Thomasjp38/Kombucha/notebooks/john/temperature.png

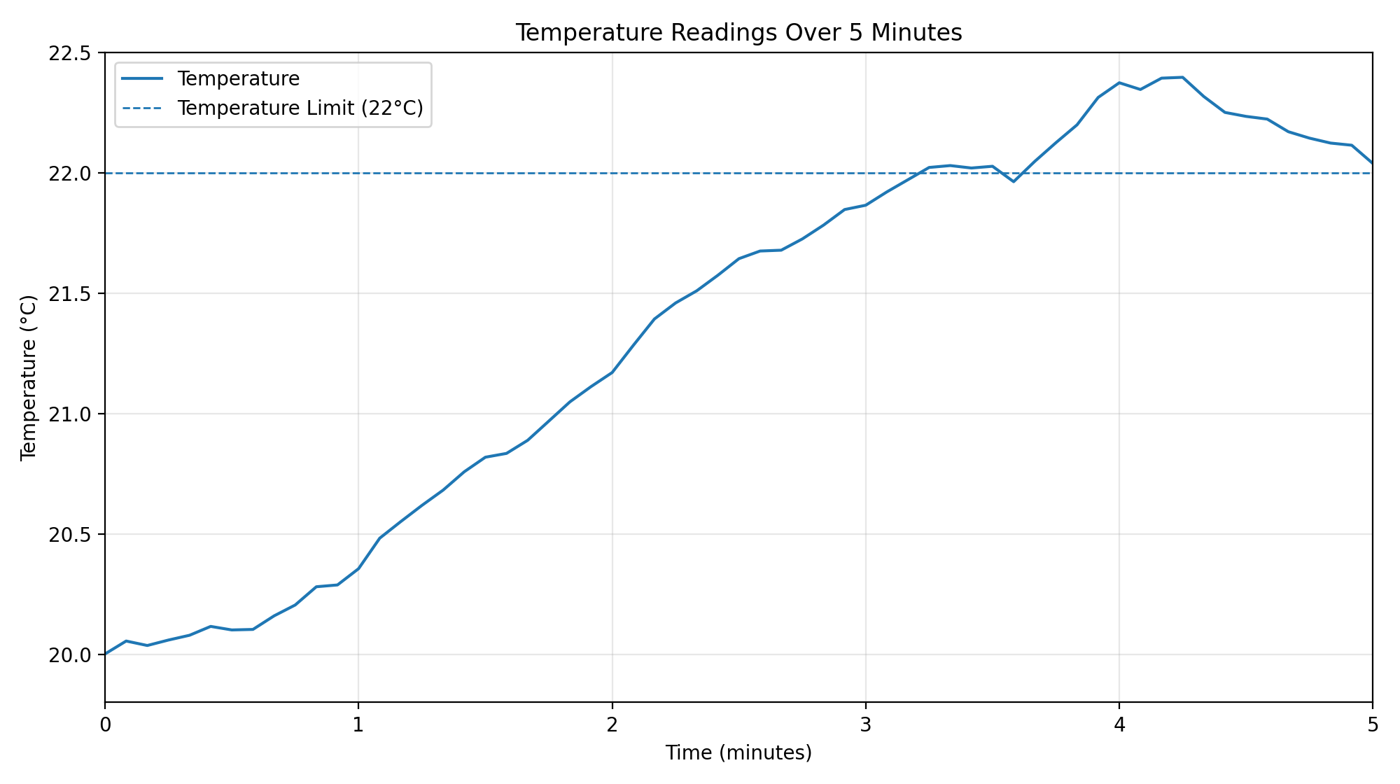
notebooks/john/temperature.png
