Thomasjp38/Kombucha/notebooks/rudy/IMG_6581.jpeg

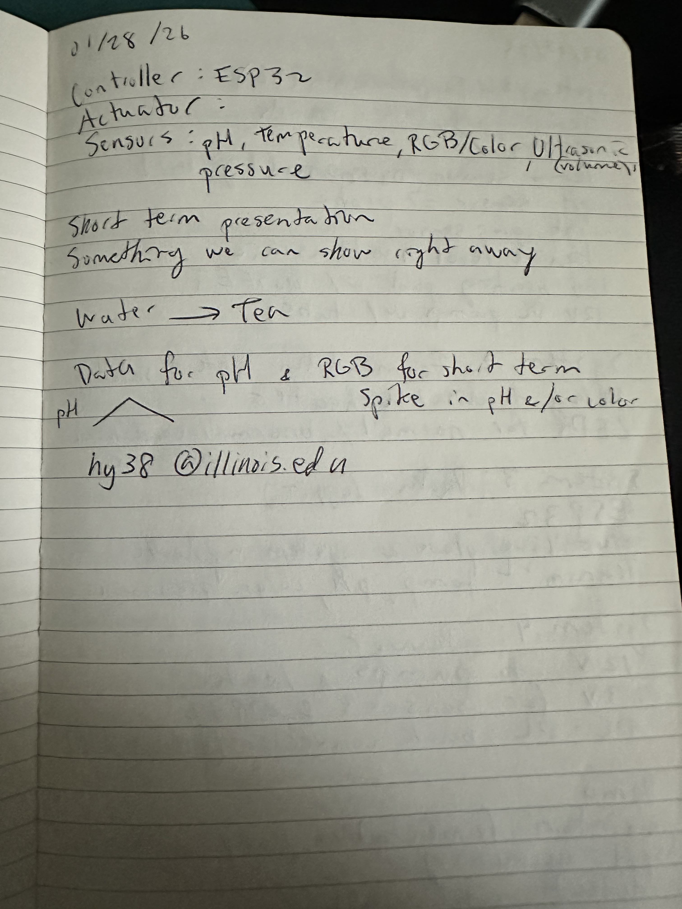
notebooks/rudy/IMG_6581.jpeg
