Thomasjp38/Kombucha/notebooks/rudy/IMG_6582.jpeg

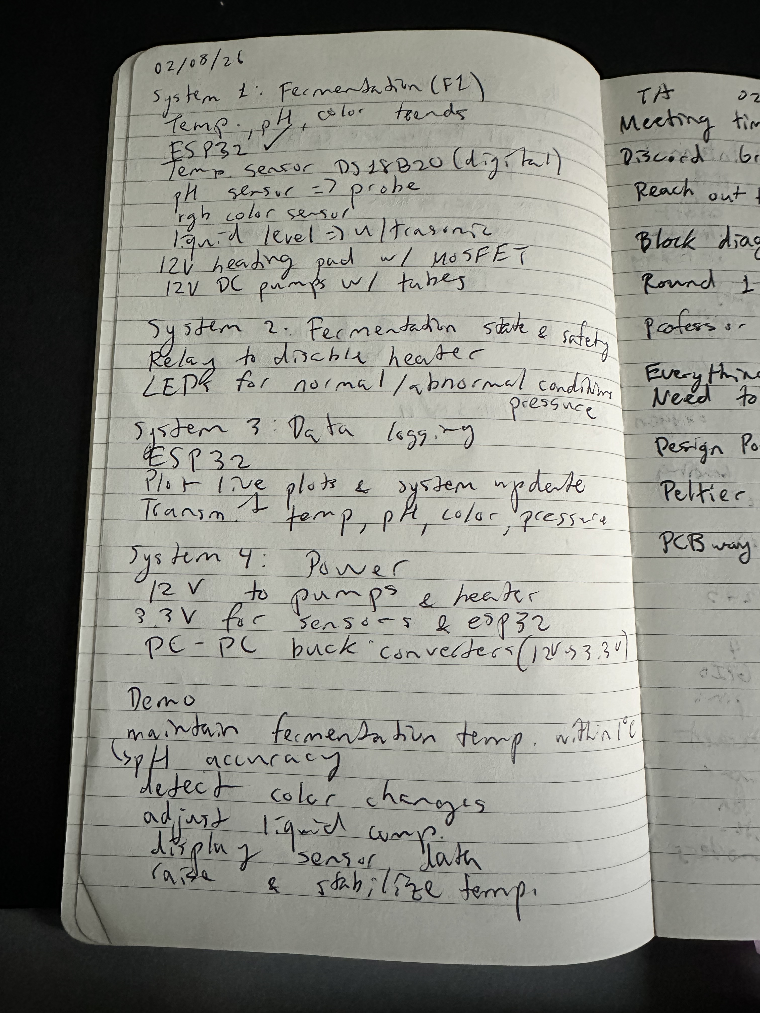
notebooks/rudy/IMG_6582.jpeg
