Thomasjp38/Kombucha/notebooks/rudy/IMG_6584.jpeg

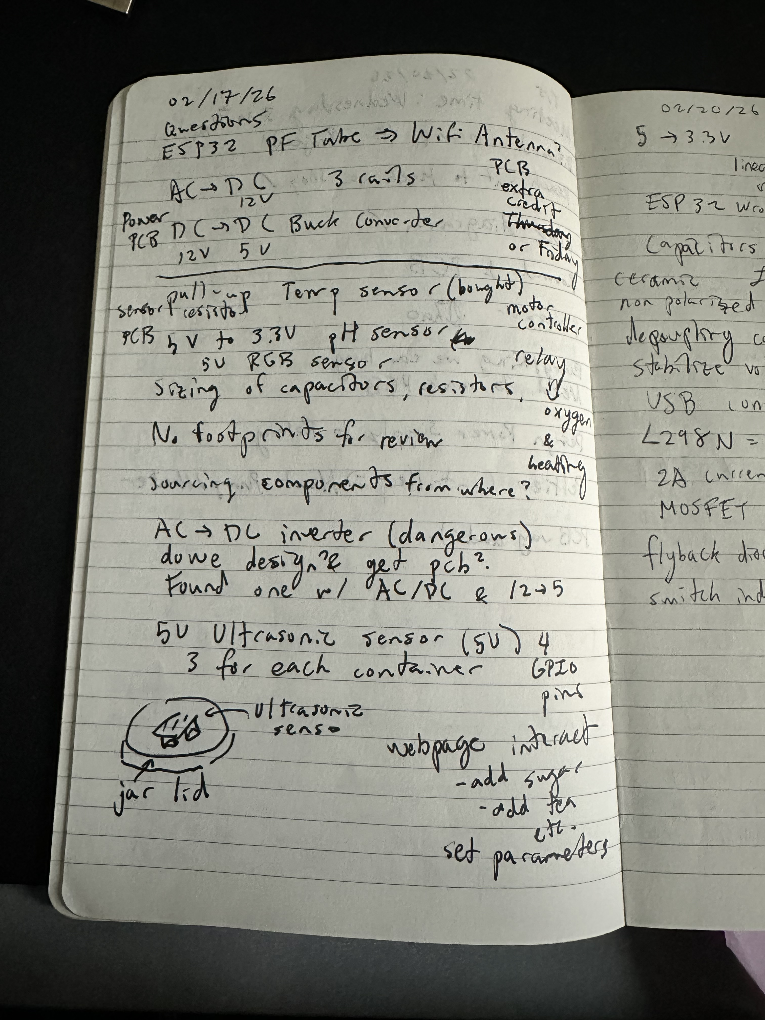
notebooks/rudy/IMG_6584.jpeg
