Thomasjp38/Kombucha/notebooks/rudy/IMG_6585.jpeg

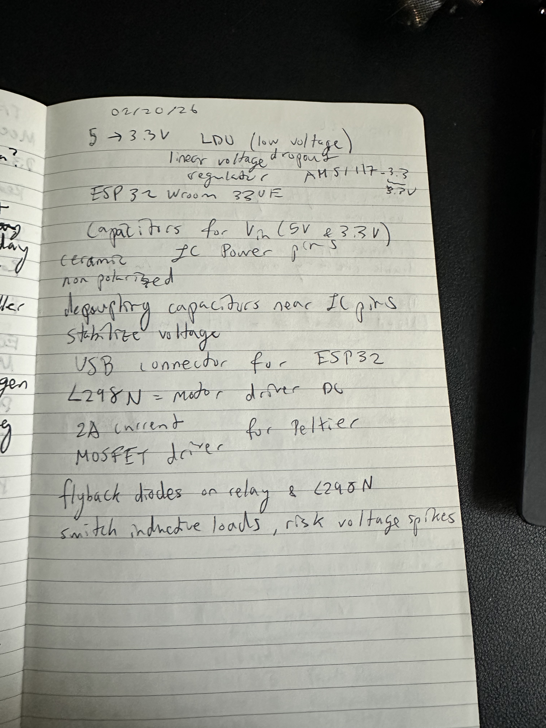
notebooks/rudy/IMG_6585.jpeg
