Thomasjp38/Kombucha/notebooks/rudy/IMG_6586.jpeg

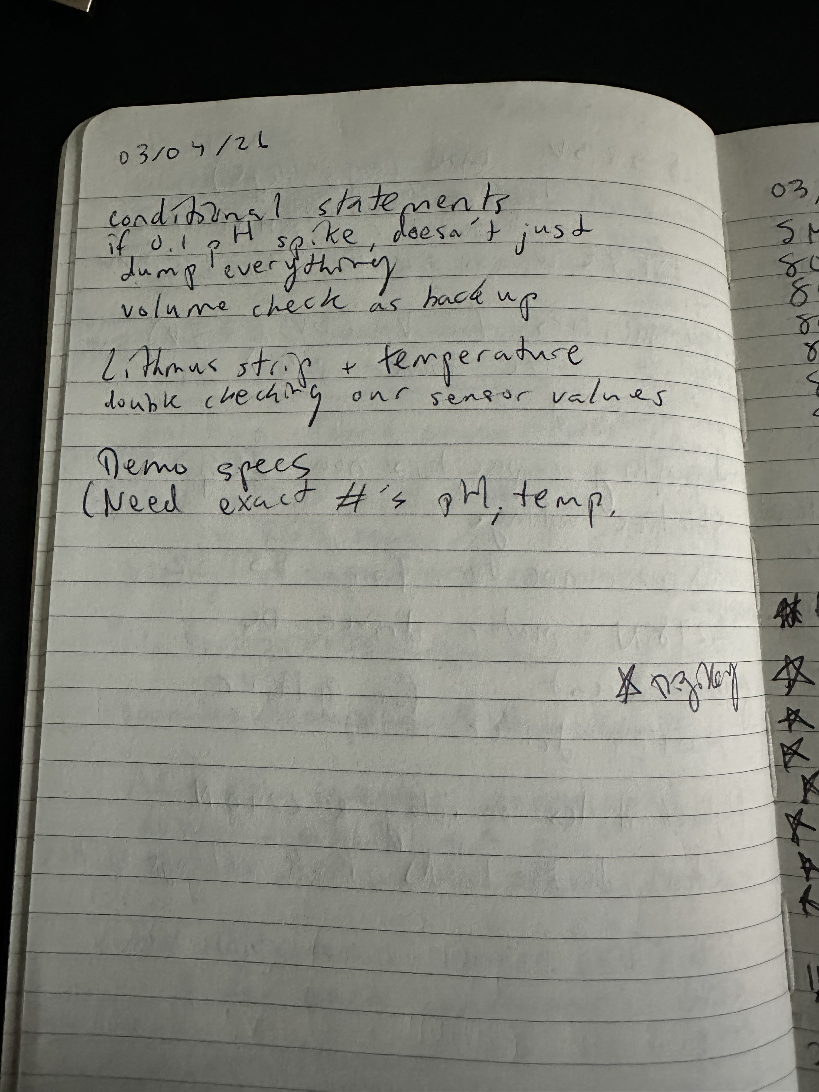
notebooks/rudy/IMG_6586.jpeg
