Thomasjp38/Kombucha/notebooks/rudy/IMG_6587.jpeg

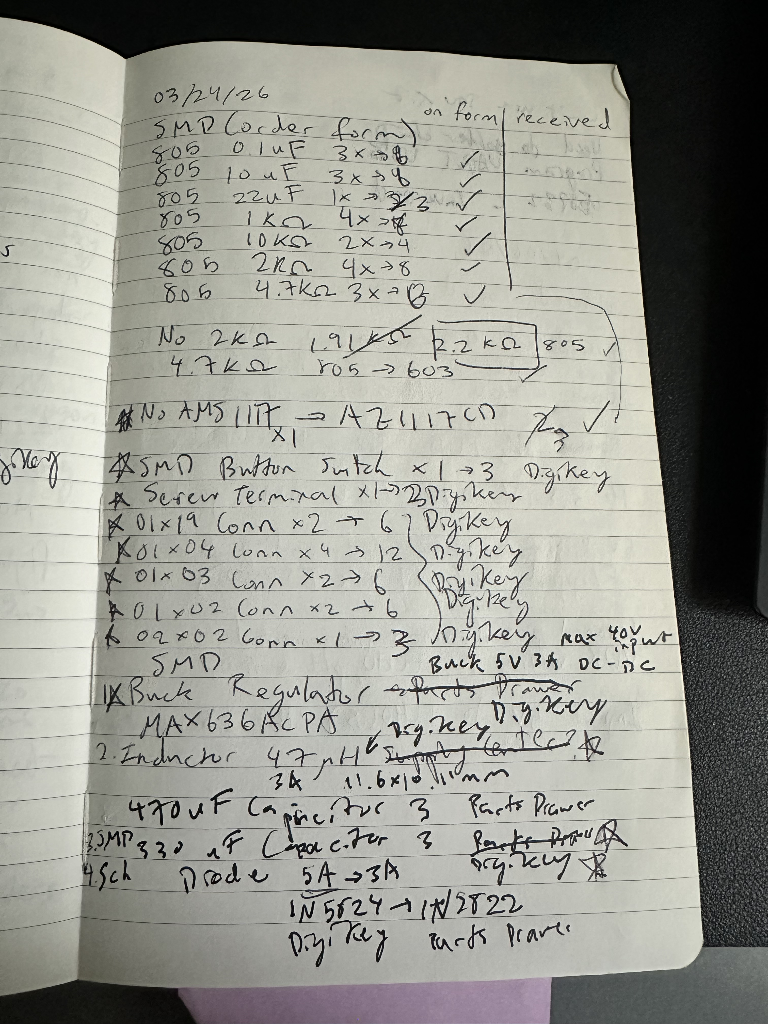
notebooks/rudy/IMG_6587.jpeg
