Thomasjp38/Kombucha/notebooks/rudy/IMG_6588.jpeg

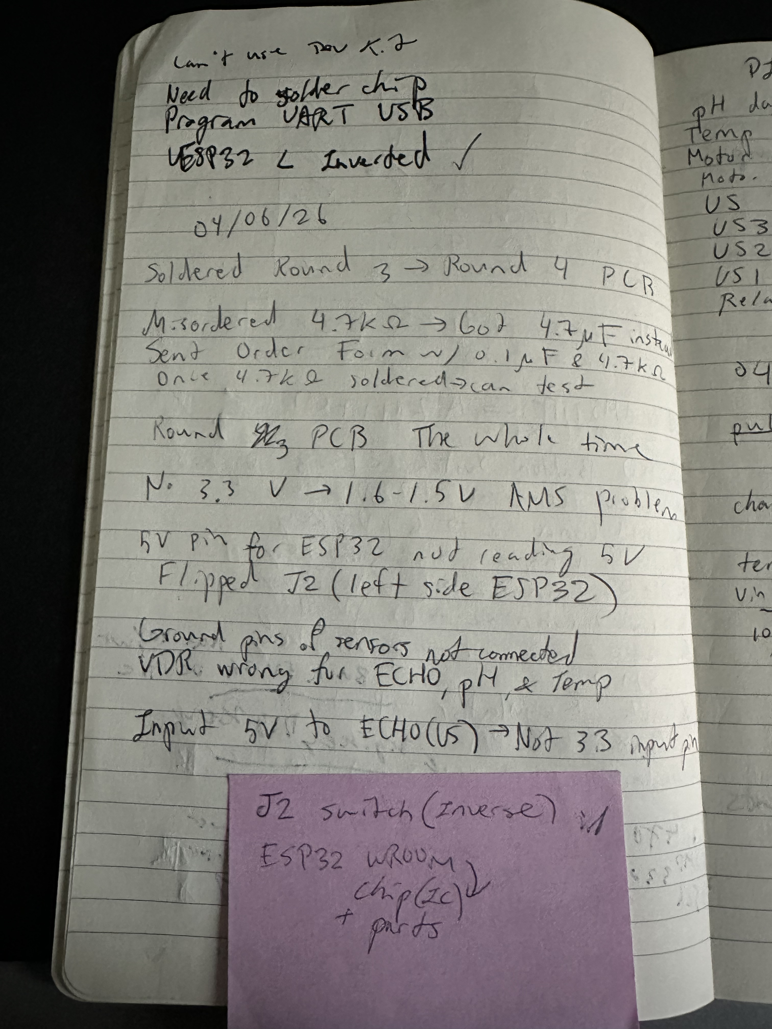
notebooks/rudy/IMG_6588.jpeg
