Thomasjp38/Kombucha/notebooks/rudy/IMG_6589.jpeg

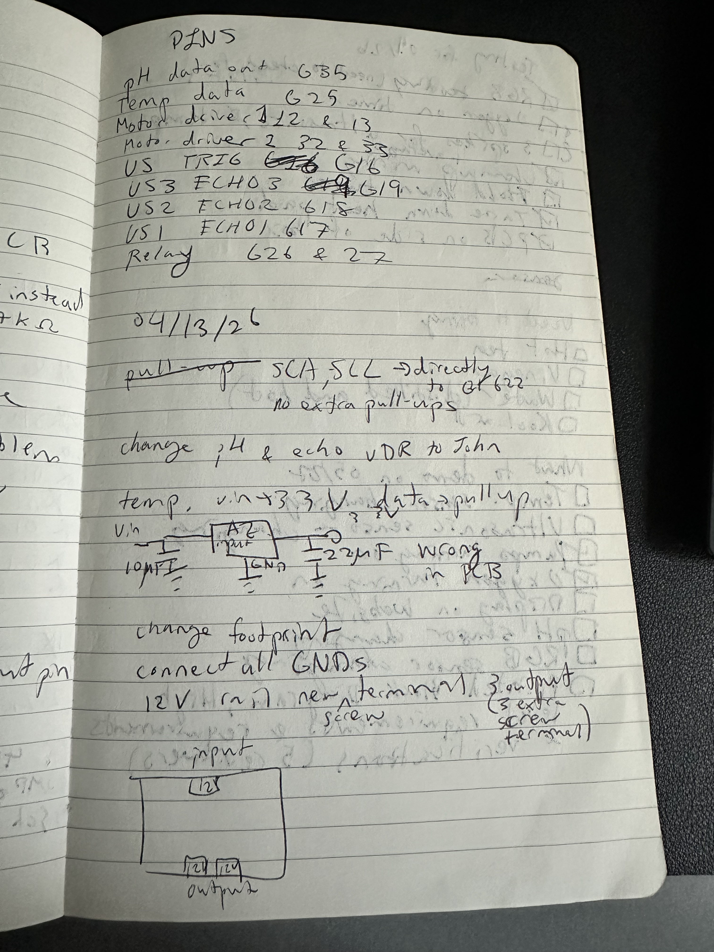
notebooks/rudy/IMG_6589.jpeg
