Thomasjp38/Kombucha/notebooks/rudy/IMG_6590.jpeg

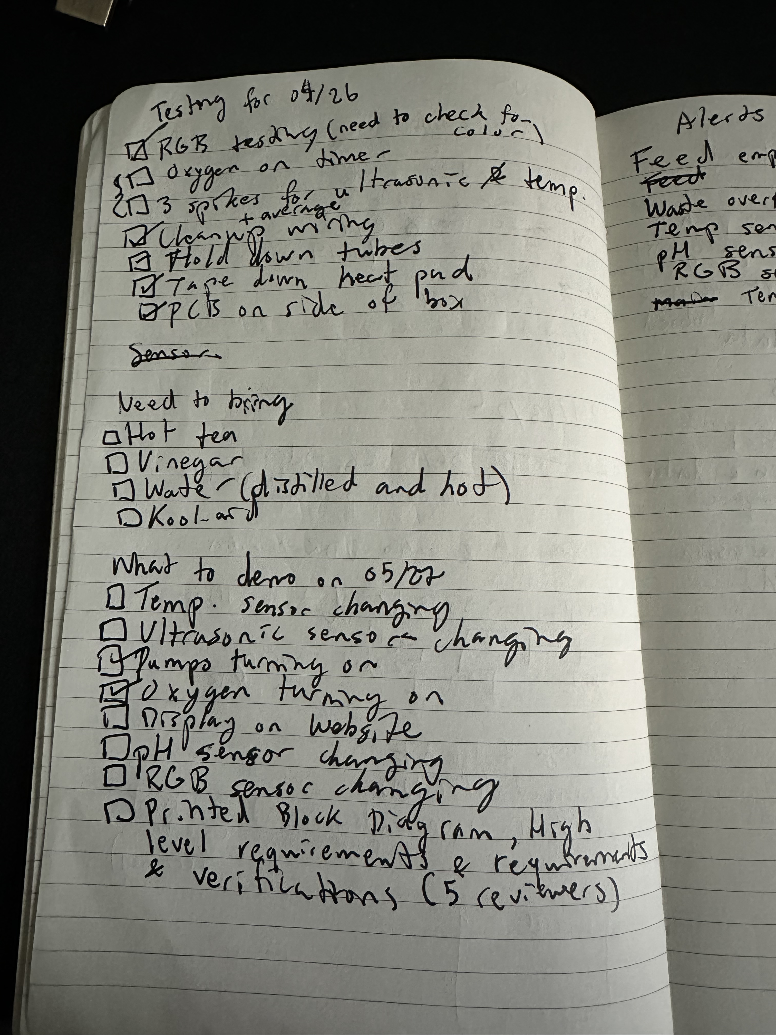
notebooks/rudy/IMG_6590.jpeg
