Thomasjp38/Kombucha/notebooks/rudy/IMG_6591.jpeg

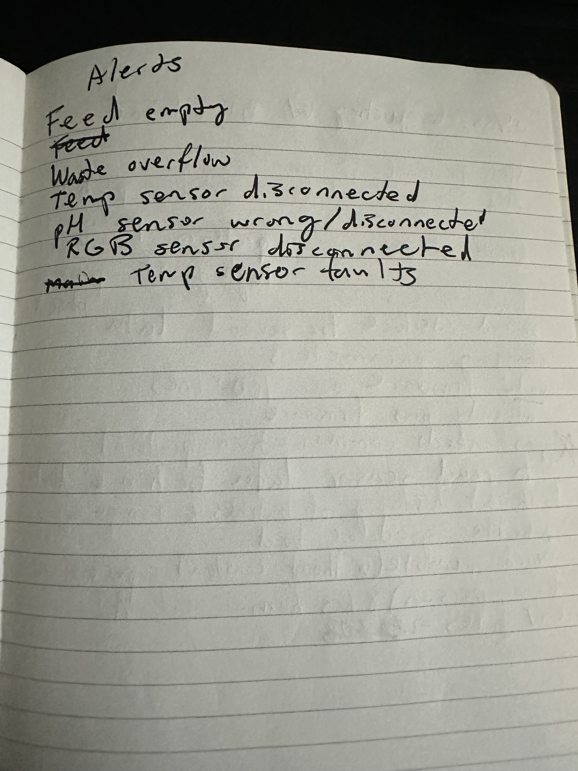
notebooks/rudy/IMG_6591.jpeg
