Thomasjp38/Kombucha/notebooks/rudy/IMG_6593.jpeg

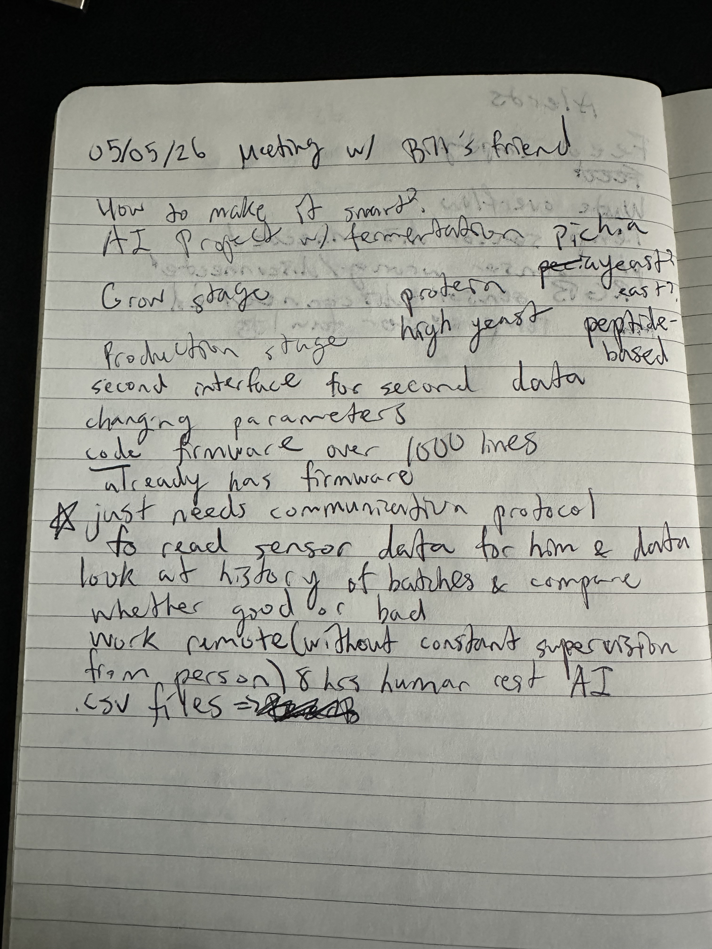
notebooks/rudy/IMG_6593.jpeg
