Thomasjp38/Kombucha/notebooks/rudy/IMG_6594.jpeg

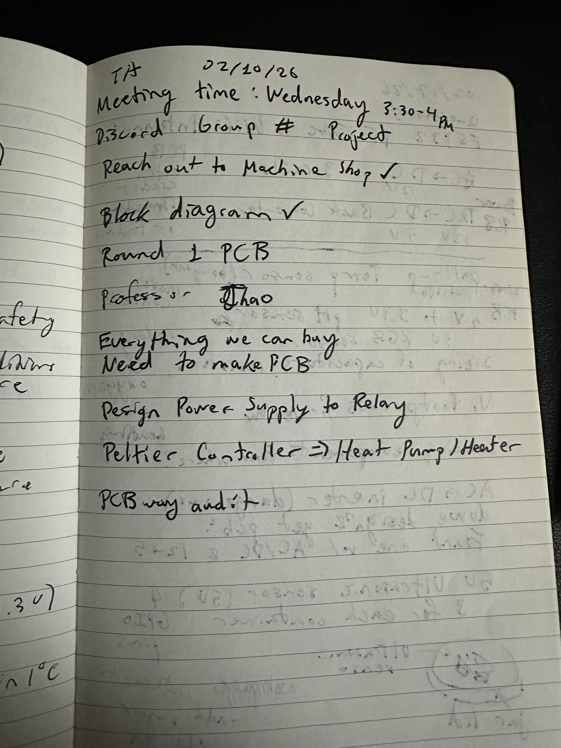
notebooks/rudy/IMG_6594.jpeg
