Thomasjp38/Kombucha/notebooks/edwin/power_board_schematic.pdf

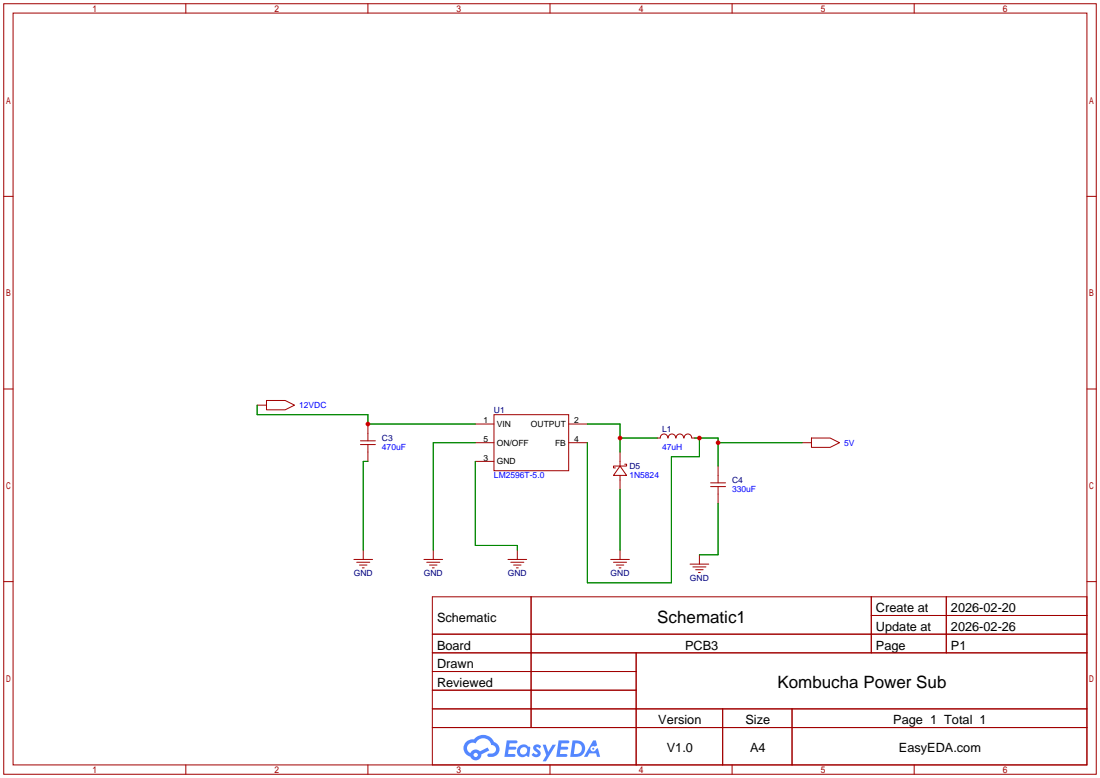
[picture p44: page 1]

Schematic | Schematic1 | Create at | 2026-02-20

Update at | 2026-02-26

Board | PCB3 | Page | P1
Drawn | | Kombucha Power Sub
Reviewed

Version | Size | Page 1 Total 1
V1.0 | A4 | EasyEDA.com
