Thomasjp38/Kombucha/notebooks/edwin/445 Power Sub.pdf

445

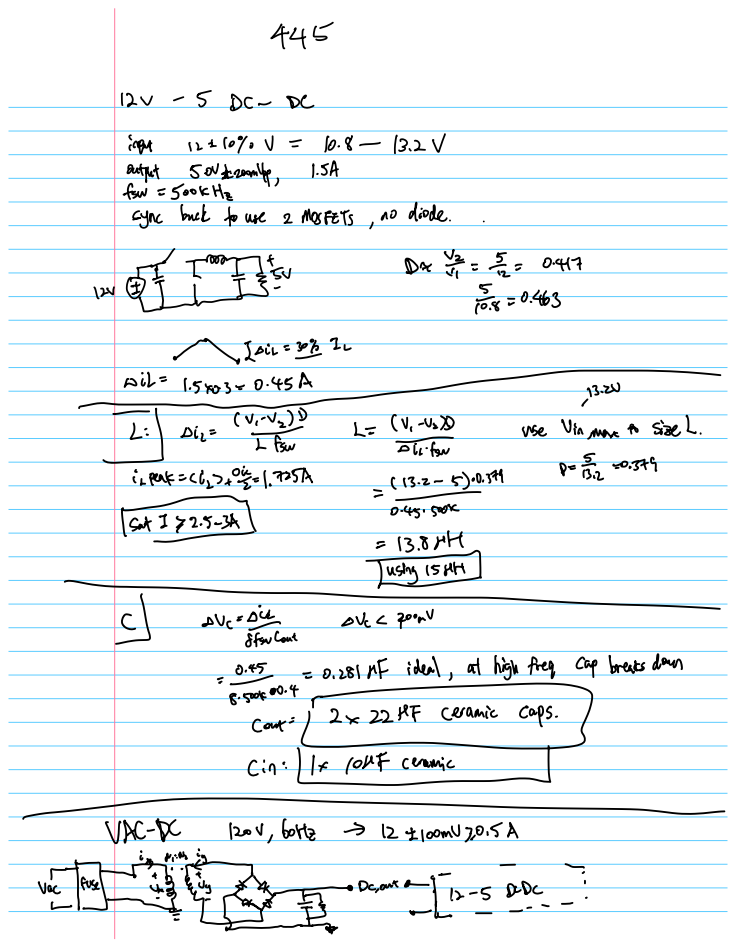
[picture p45: page 1]
ÉÉÉ; cont 52x22HFceramiscaps.mn ii i; u.EEiiEIEiEi eEEs

input 12110 U 10.8 13.2

output 5OVE.com.uy 1.5A
fjnisbi.itfouse2Mosfets no diode
ELIOTTI D E 0417

fÉIff f I
lsat172.5 3AI-fjff f

0.281nF ideal at highfreq cap breaksdown

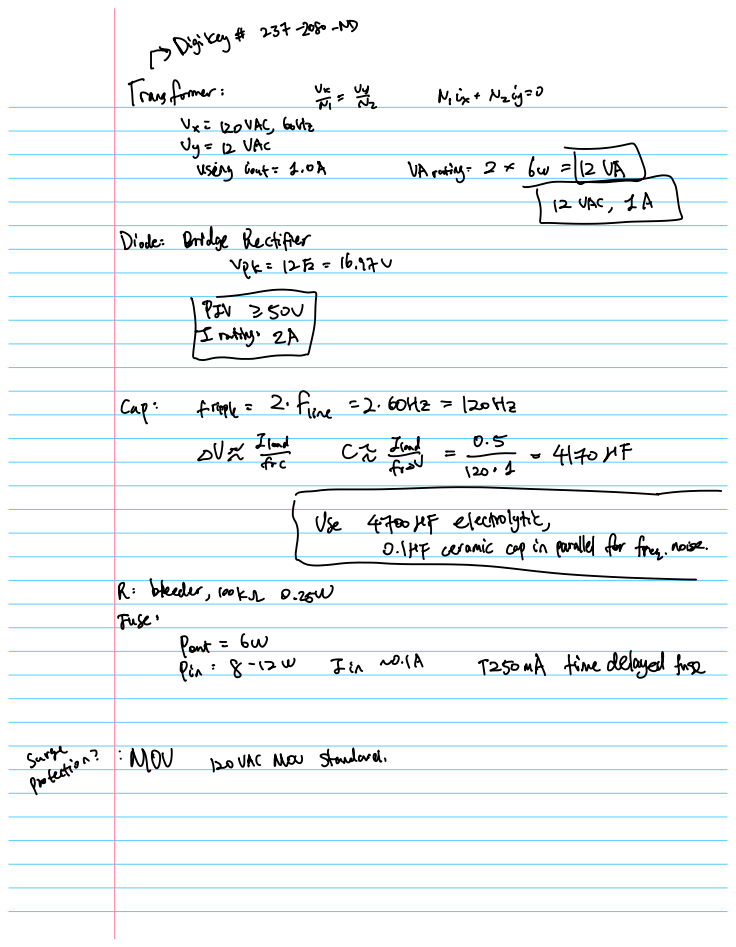
[picture p46: page 2]
Iftion; MOV 120VAC Mou standard

Digikey 237 ²⁰⁸⁰ ND Transformer YE N Ix Nzig o

VxI 120VAC GHz

1 A Varating 2 bw 1

12UAC.LA

Diode Bridge Rectifier

Vak 125 16.970

Cap fripple 2 fine 2 6042 120Hz
OVE C 4170nF

L Fcet.IM ti rallelfrfra.no

R bleeder looks 0.25W
fuse

8 2 w zin o.LA 5250mA timedelayedfuse
