Thomasjp38/Kombucha/pump_stand/Finalcompleterig (1).pdf

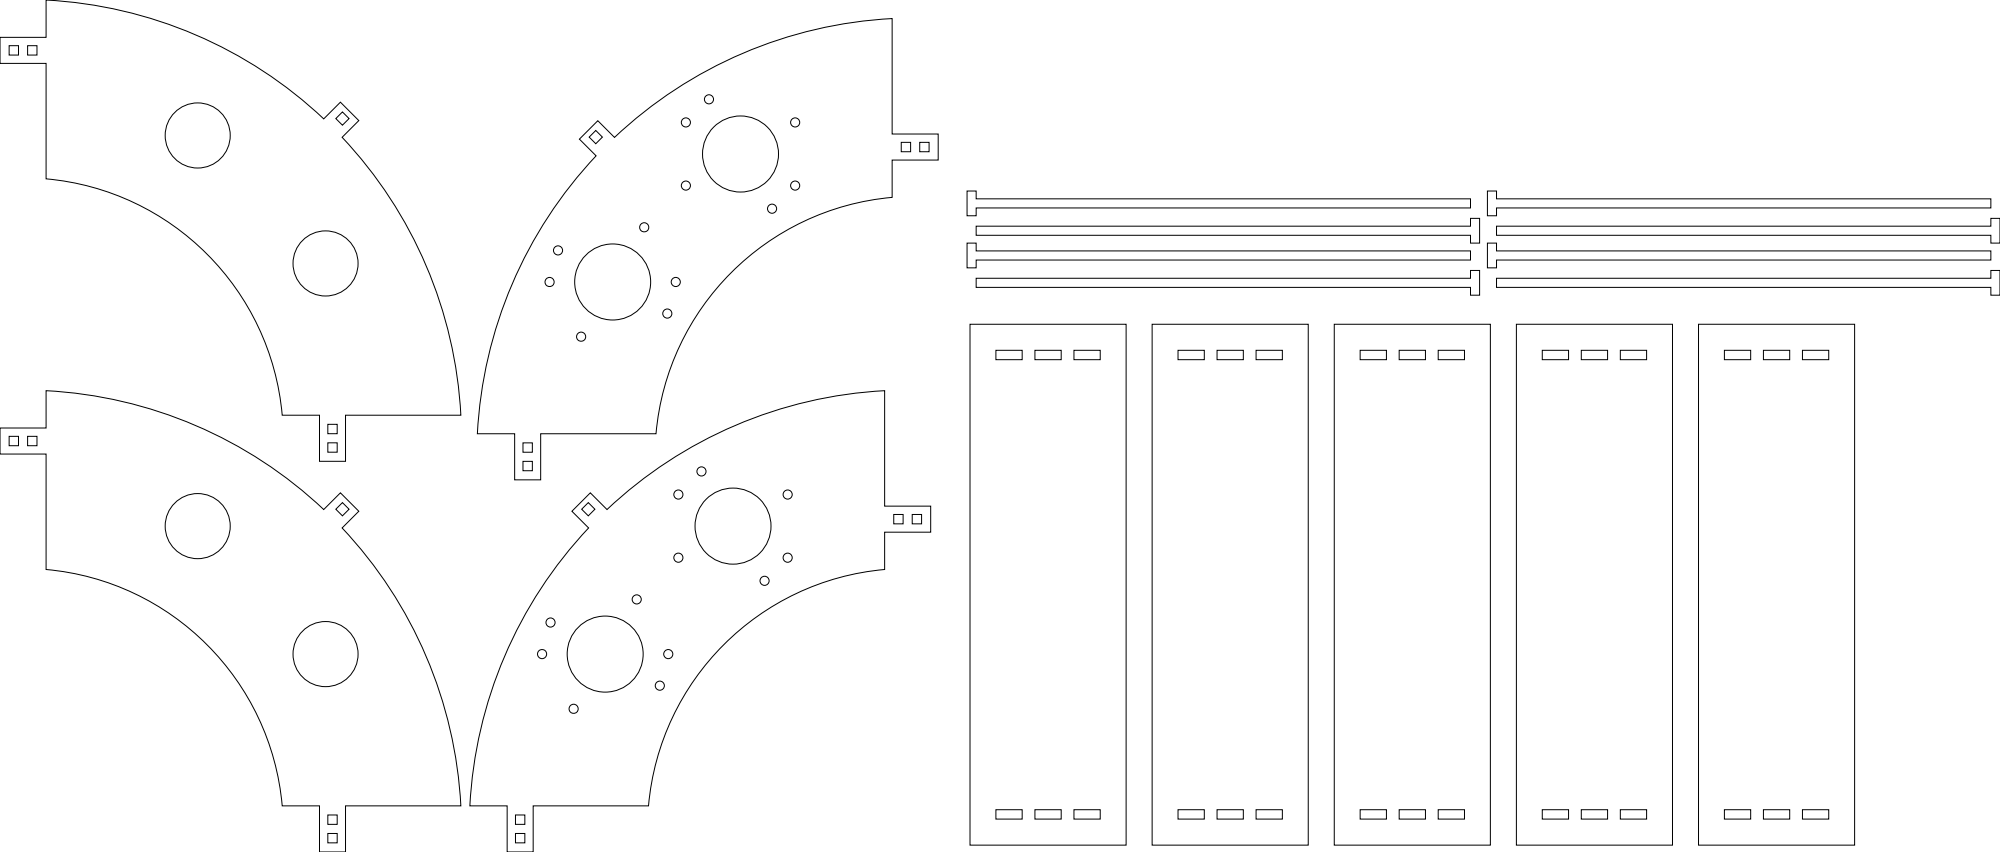
[picture p47: page 1]
