Thomasjp38/Kombucha/notebooks/edwin/power_pcb.pdf

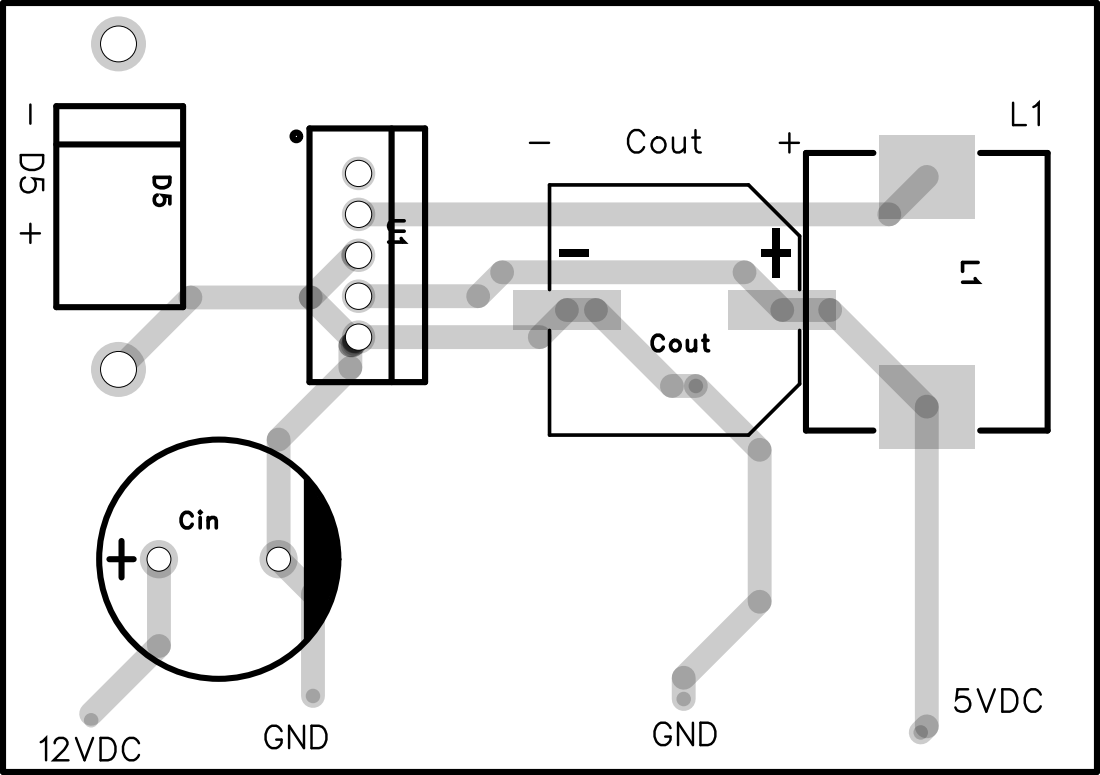
[picture p48: page 1]

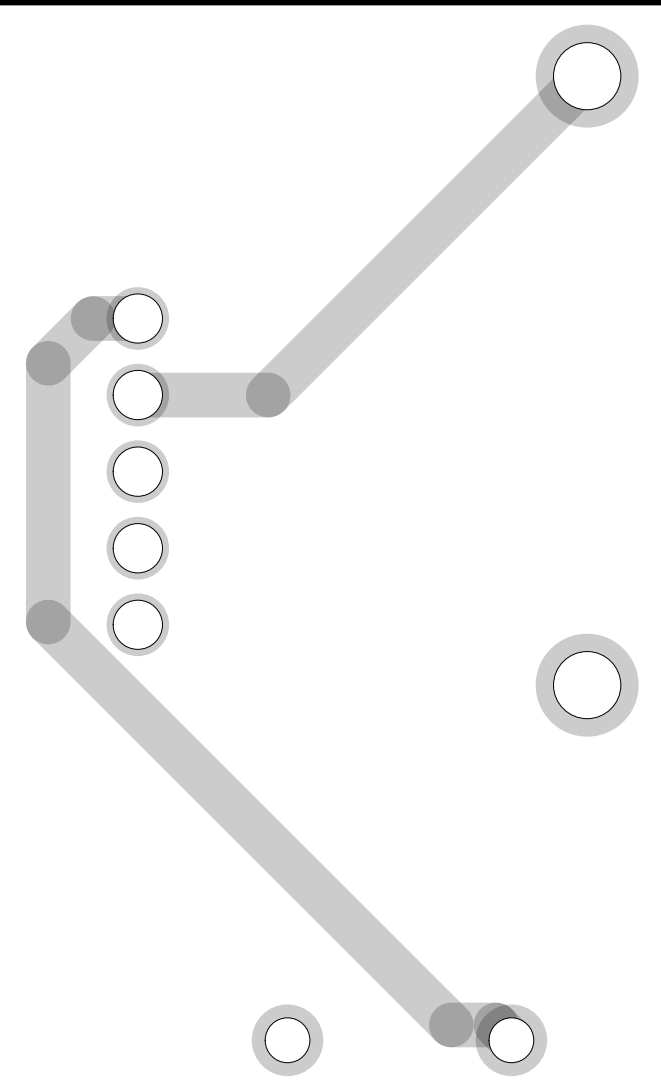
[picture p49: page 2]
