Thomasjp38/Kombucha/PCB Files/rudyb2_kombucha_sensor+relay.kicad_pcb

## KiCad design PCB Files/rudyb2_kombucha_sensor+relay.kicad_pcb (2026-05-07)

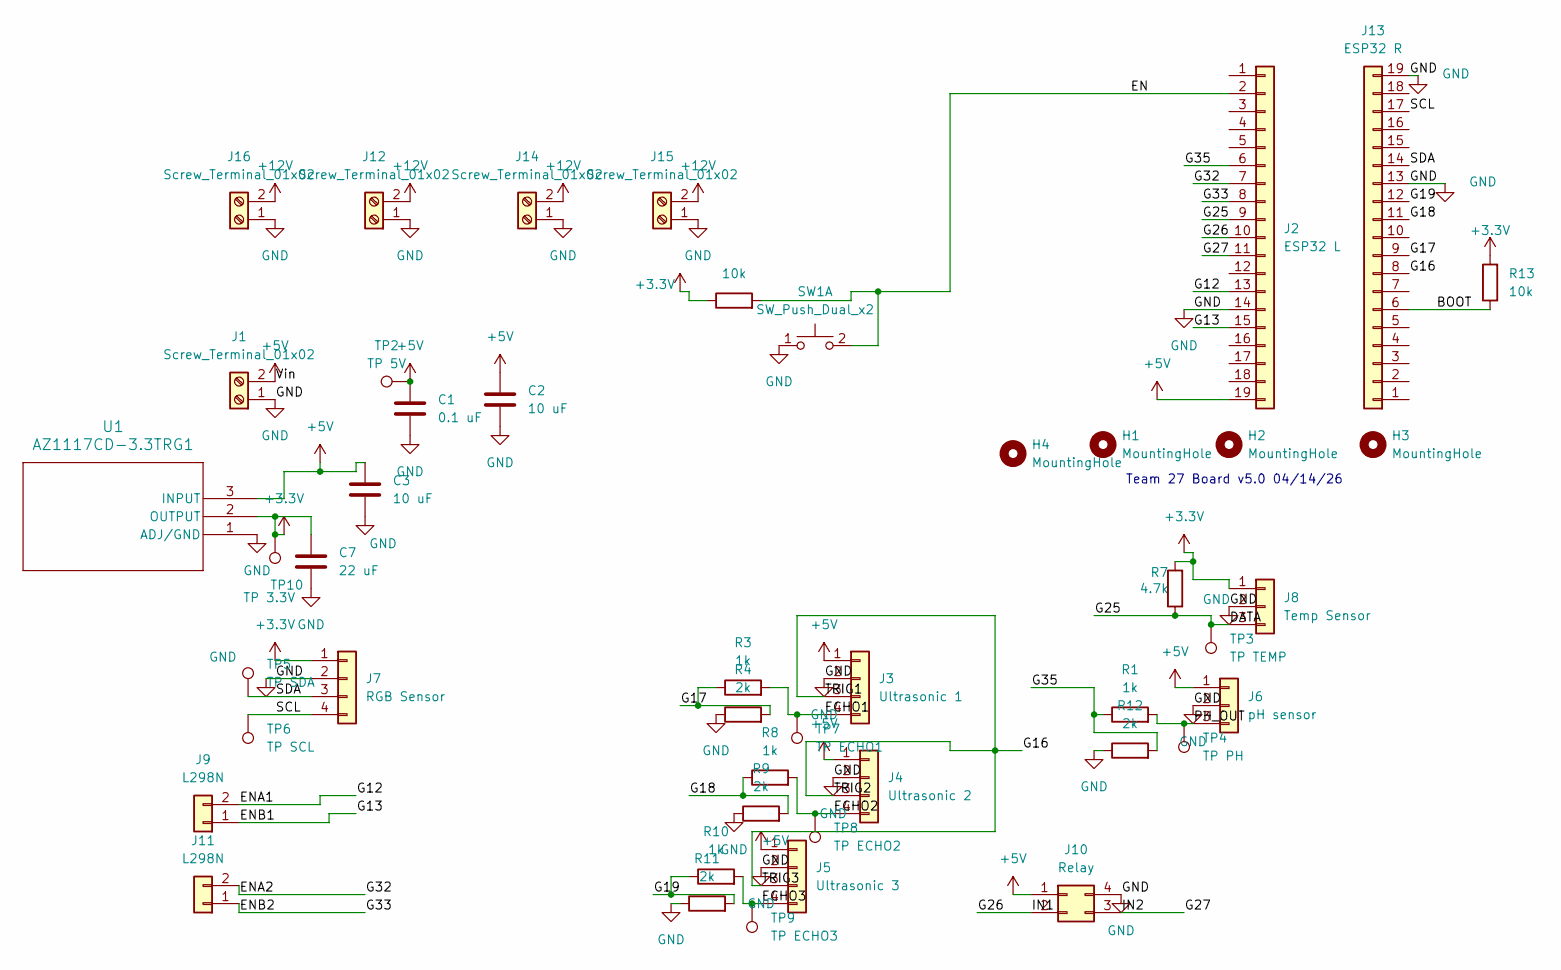
[picture p50: schematic rudyb2_kombucha_sensor+relay.kicad_sch]

Parts:
C1: 0.1 uF; C_0805_2012Metric_Pad1.18x1.45mm_HandSolder
C2, C3: 10 uF; C_0805_2012Metric_Pad1.18x1.45mm_HandSolder
C7: 22 uF; C_0805_2012Metric_Pad1.18x1.45mm_HandSolder
H1, H2, H3, H4: MountingHole; MountingHole_3.2mm_M3
J1, J12, J14, J15, J16: Screw_Terminal_01x02; TerminalBlock_Xinya_XY308-2.54-2P_1x02_P2.54mm_Horizontal
J2: ESP32 L; Molex_SL_171971-0019_1x19_P2.54mm_Vertical
J3: Ultrasonic 1; Molex_KK-254_AE-6410-04A_1x04_P2.54mm_Vertical
J4: Ultrasonic 2; Molex_KK-254_AE-6410-04A_1x04_P2.54mm_Vertical
J5: Ultrasonic 3; Molex_KK-254_AE-6410-04A_1x04_P2.54mm_Vertical
J6: pH sensor; Molex_KK-254_AE-6410-03A_1x03_P2.54mm_Vertical
J7: RGB Sensor; Molex_KK-254_AE-6410-04A_1x04_P2.54mm_Vertical
J8: Temp Sensor; Molex_KK-254_AE-6410-03A_1x03_P2.54mm_Vertical
J9, J11: L298N; Molex_KK-254_AE-6410-02A_1x02_P2.54mm_Vertical
J10: Relay; Molex_Micro-Fit_3.0_43045-0400_2x02_P3.00mm_Horizontal
J13: ESP32 R; Molex_SL_171971-0019_1x19_P2.54mm_Vertical
R1, R3, R8, R10: 1k; R_0805_2012Metric_Pad1.20x1.40mm_HandSolder
R2, R13: 10k; R_0805_2012Metric_Pad1.20x1.40mm_HandSolder
R4, R9, R11, R12: 2k; R_0805_2012Metric_Pad1.20x1.40mm_HandSolder
R7: 4.7k; R_0805_2012Metric_Pad1.20x1.40mm_HandSolder
SW1: SW_Push_Dual_x2; SW_SPST_B3S-1000
TP2: TP 5V; TestPoint_Pad_D1.5mm
TP3: TP TEMP; TestPoint_Pad_D1.5mm
TP4: TP PH; TestPoint_Pad_D1.5mm
TP5: TP SDA; TestPoint_Pad_D1.5mm
TP6: TP SCL; TestPoint_Pad_D1.5mm
TP7: TP ECHO1; TestPoint_Pad_D1.5mm
TP8: TP ECHO2; TestPoint_Pad_D1.5mm
TP9: TP ECHO3; TestPoint_Pad_D1.5mm
TP10: TP 3.3V; TestPoint_Pad_D1.5mm
U1: AZ1117CD-3.3TRG1; DPAK457P1010X238-3N

Connections:
+3.3V: C7.1, J7.1, J8.1, R2.1, R7.2, R13.2, TP10.1, U1.2 (OUTPUT)
+5V: C1.1, C2.1, C3.1, J1.2, J2.19, J3.1, J4.1, J5.1, J6.1, J10.1, TP2.1, U1.3 (INPUT)
+12V: J12.2, J14.2, J15.2, J16.2
/BOOT: J13.6, R13.1
/DATA: J2.9, J8.3, R7.1, TP3.1
/ECHO1: J3.4, R3.2, TP7.1
/ECHO2: J4.4, R8.2, TP8.1
/ECHO3: J5.4, R10.2, TP9.1
/EN: J2.2, R2.2, SW1.2 (D)
/ENA1: J2.13, J9.2
/ENA2: J2.7, J11.2
/ENB1: J2.15, J9.1
/ENB2: J2.8, J11.1
/G16: J3.3, J4.3, J5.3, J13.8
/G17: J13.9, R3.1, R4.2
/G18: J13.11, R8.1, R9.2
/G19: J13.12, R10.1, R11.2
/G26: J2.10, J10.2
/G27: J2.11, J10.3
/G35: J2.6, R1.1, R12.2
/PH_OUT: J6.3, R1.2, TP4.1
/SCL: J7.4, J13.17, TP6.1
/SDA: J7.3, J13.14, TP5.1
GND: C1.2, C2.2, C3.2, C7.2, J1.1, J2.14, J3.2, J4.2, J5.2, J6.2, J7.2, J8.2, J10.4, J12.1, J13.13, J13.19, J14.1, J15.1, J16.1, R4.1, R9.1, R11.1, R12.1, SW1.1 (C), U1.1 (ADJ/GND)

Notes on the sheet:
Team 27 Board v5.0 04/14/26

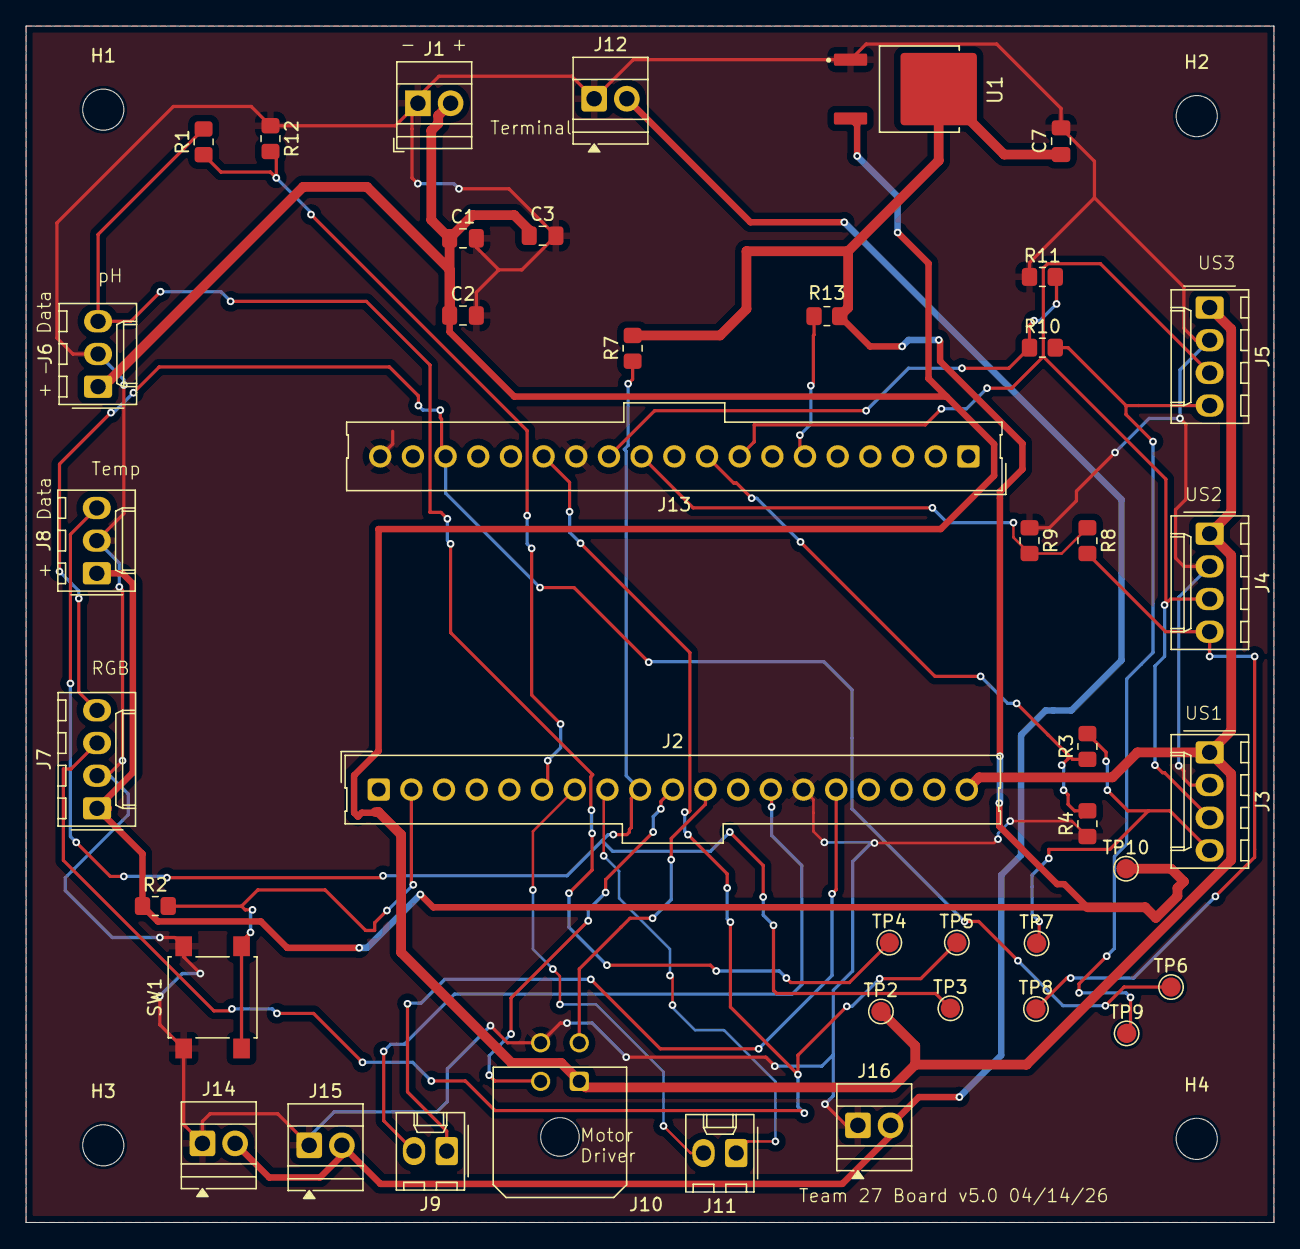
[picture p51: board rudyb2_kombucha_sensor+relay.kicad_pcb from above]

Board: 2 copper layers, 97.0 x 93.0 mm, 46 parts (0 on the bottom side), 24 nets.
