Thomasjp38/Kombucha/(commit log)

2026-02-18 Add files via upload
    Fermentation System Prototype
2026-02-18 Update README.md
    added prototype image to Readme
2026-02-20 Add files via upload
    Notes for Power Subsytem
2026-02-20 Add files via upload
    Initial code for read US sensors, with added multiplexing feature. Confirmed working.
2026-02-20 Update and rename UltrasonicArray.cpp to code/UltrasonicArray.cpp
2026-02-20 Update and rename UltrasonicArray.h to code/UltrasonicArray.h
2026-02-25 Temp sensor successfully working
2026-02-25 Pump stand/jar
2026-02-25 Update and rename Circleholder2.svg to pump_stand/Circleholder2.svg
2026-02-25 Update and rename Circlemotor2.svg to pump_stand/Circlemotor2.svg
2026-02-25 Update and rename Circlepin2.svg to pump_stand/Circlepin2.svg
2026-02-27 Motor controller for peristaltic pumps operational
2026-03-03 Improve sensor read efficiency with quiet-time gating and cached connection checks
2026-03-25 Create PCB Files
2026-03-25 Update PCB Files
2026-05-08 Add files via upload
    added schematic and PCB
